elevans/atomic_36/README.md

# atomic_36
My take on a 36 key open source keyboard.
