elevans/atomic_36/case/board_case_with_heated_insert.stl

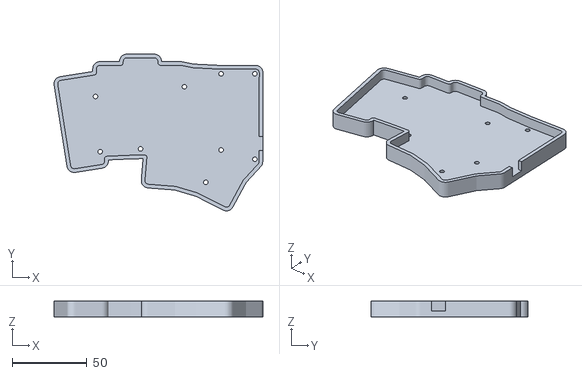
[picture p1: CAD file, 2026-09-09]
case/board_case_with_heated_insert.stl
139.7 x 104.8 x 10.5
