elevans/atomic_36/case/mcu_cover_case.stl

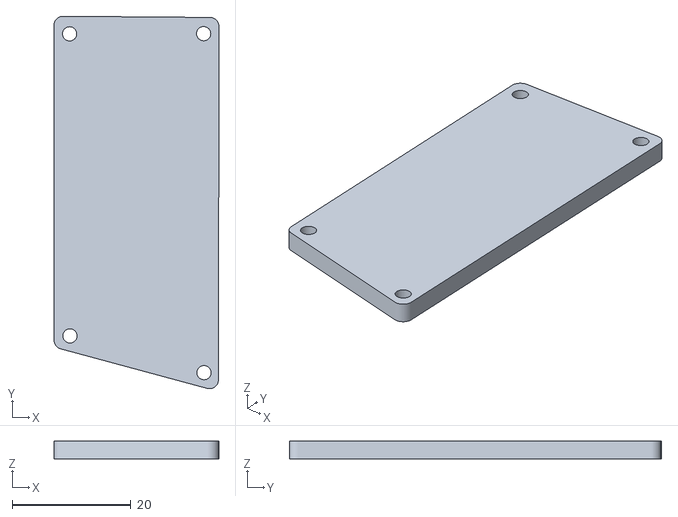
[picture p2: CAD file, 2026-09-05]
case/mcu_cover_case.stl
27.8 x 62.8 x 3.00
