elevans/atomic_36/case/board_case_border_test.stl

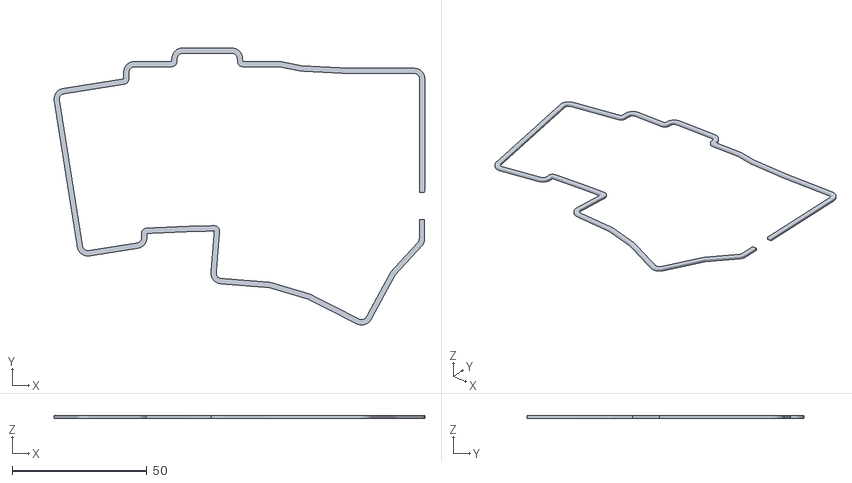
[picture p3: CAD file, 2026-09-05]
case/board_case_border_test.stl
137.9 x 103.0 x 1.00
