elevans/atomic_36/case/switch_plate_case.stl

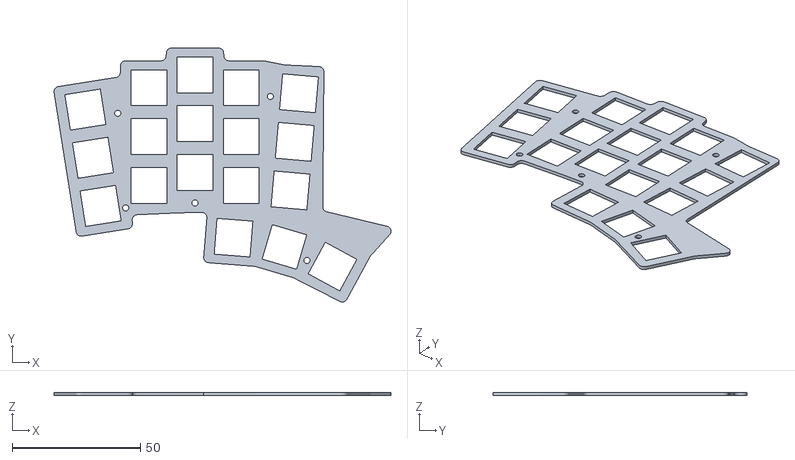
[picture p4: CAD file, 2026-09-05]
case/switch_plate_case.stl
131.3 x 99.0 x 1.20
