elevans/atomic_36/case/board_case.stl

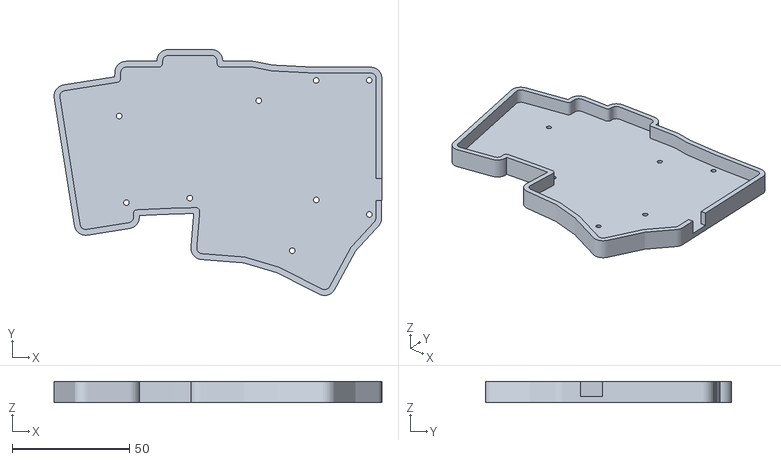
[picture p5: CAD file, 2026-09-05]
case/board_case.stl
139.7 x 104.8 x 9.00
