elevans/atomic_36/pcb/atomic_36.kicad_pcb

## KiCad design pcb/atomic_36.kicad_pcb (2026-08-27)

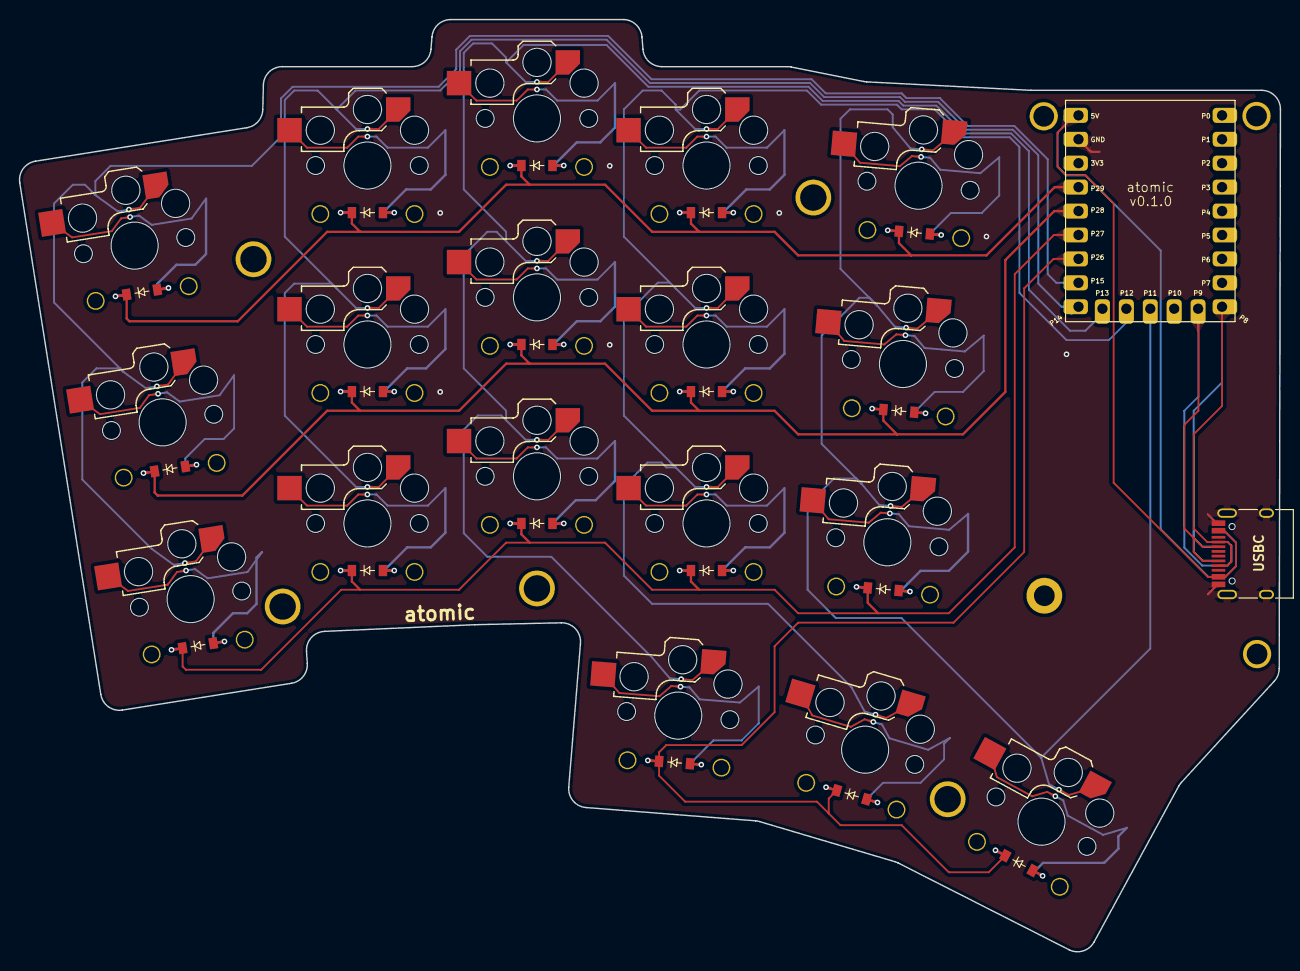
[picture p6: board atomic_36.kicad_pcb from above]

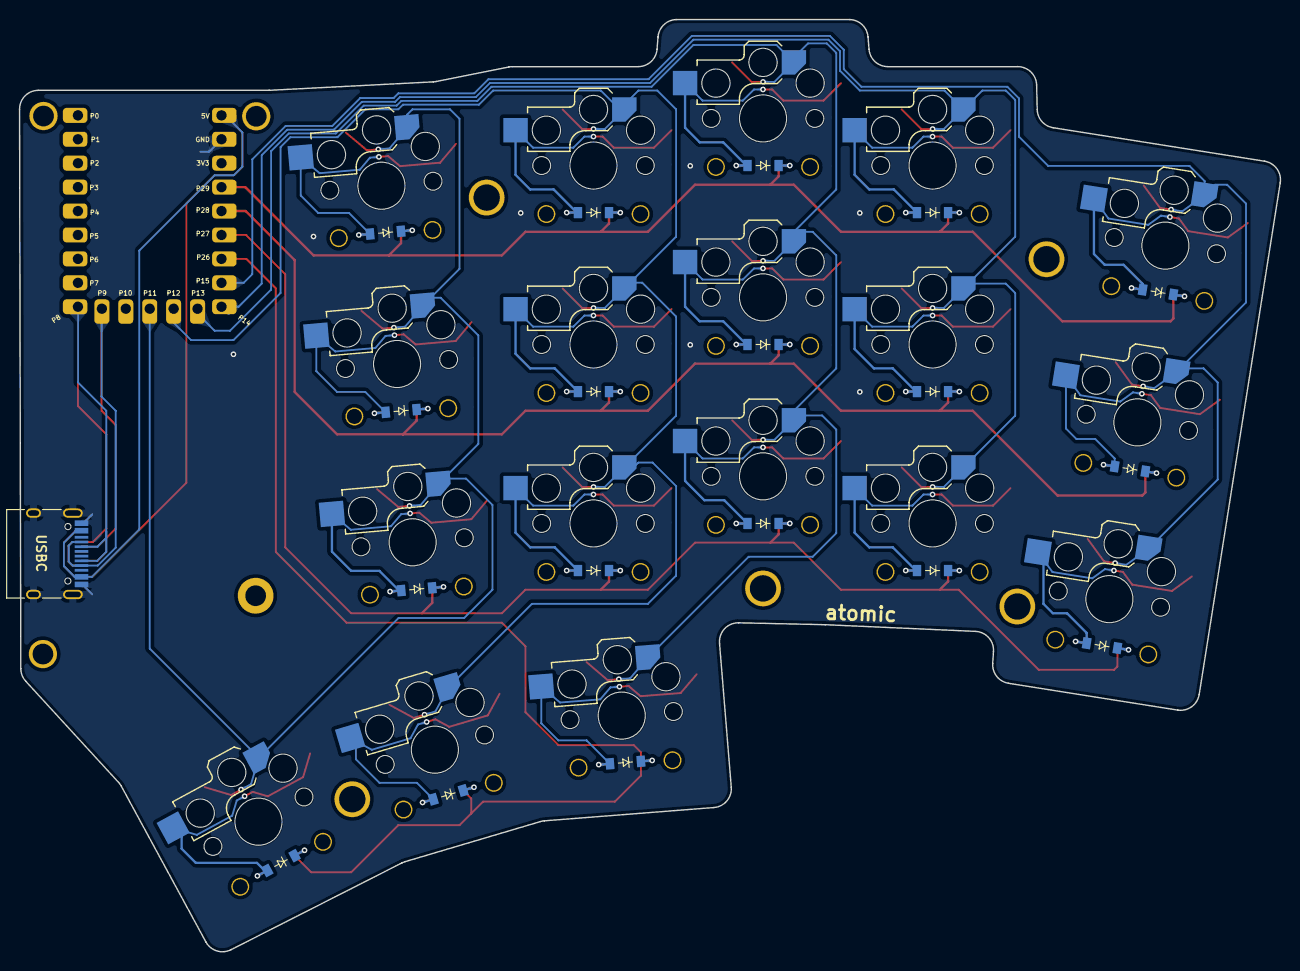
[picture p7: board atomic_36.kicad_pcb from below]

Board: 2 copper layers, 133.9 x 99.0 mm, 47 parts (18 on the bottom side), 31 nets.

Parts:
D1, D2, D3, D4, D5, D6, D7, D8, D9, D10, D11, D12, D13, D14, D15, D16, D17, D18: diode_tht_sod123
H1, H2, H3, H4, H5, H6, H7, H7#2, H9: mounting_hole_plated
J1: USB_C_12P; USB_C_Receptacle_HRO_TYPE-C-31-M-12_Reversible
RP2040Zero1: RP2040-Zero
S1, S2, S3, S4, S5, S6, S7, S8, S9, S10, S11, S12, S13, S14, S15, S16, S17, S18: switch_choc_v1_v2

Connections:
GND: J1.B1, J1.B12, J1.F1, J1.F12, J1.S1, RP2040Zero1.20
GP8: J1.B5, J1.B8, J1.F4, J1.F9, RP2040Zero1.9
GP9: J1.B4, J1.B9, J1.F5, J1.F8, RP2040Zero1.10
GP11: RP2040Zero1.12, S13.1, S14.1, S15.1, S18.1
GP12: RP2040Zero1.13, S10.1, S11.1, S12.1, S17.1
GP13: RP2040Zero1.14, S7.1, S8.1, S9.1, S16.1
GP14: RP2040Zero1.15, S4.1, S5.1, S6.1
GP15: RP2040Zero1.16, S1.1, S2.1, S3.1
GP26: D16.1, D17.1, D18.1, RP2040Zero1.17
GP27: D1.1, D4.1, D7.1, D10.1, D13.1, RP2040Zero1.18
GP28: D2.1, D5.1, D8.1, D11.1, D14.1, RP2040Zero1.22
GP29: D3.1, D6.1, D9.1, D12.1, D15.1, RP2040Zero1.23
P5V: J1.B2, J1.B11, J1.F2, J1.F11, RP2040Zero1.19
index_bottom: D10.2, S10.2
index_home: D11.2, S11.2
index_top: D12.2, S12.2
inner_bottom: D13.2, S13.2
inner_home: D14.2, S14.2
inner_top: D15.2, S15.2
layer_cluster: D17.2, S17.2
middle_bottom: D7.2, S7.2
middle_home: D8.2, S8.2
middle_top: D9.2, S9.2
mod_cluster: D16.2, S16.2
pinky_bottom: D1.2, S1.2
pinky_home: D2.2, S2.2
pinky_top: D3.2, S3.2
ring_bottom: D4.2, S4.2
ring_home: D5.2, S5.2
ring_top: D6.2, S6.2
space_cluster: D18.2, S18.2
