elevans/atomic_36/(commit log)

2026-08-16 Initial commit, add footprints and erogen yml
2026-08-16 Add board outline
2026-08-16 Improve board outline, add combo view
2026-08-16 Refine board outline
2026-08-16 Add switch plate and pcb board
2026-08-16 Fix space thumb cluster pos, clashing
    [atomic_36_config.yaml]
2026-08-17 Fixed rp2040zero footprint, credit chatGPT 5.6
2026-08-17 Add diode and mcu pcb sections
2026-08-17 Add board mirroring, bump to 4.2.1 erogen engine
2026-08-17 Fix x position in outlines
    [atomic_36_config.yaml]
2026-08-17 Remove mirror, we're going reversable
    [atomic_36_config.yaml]
2026-08-17 Add reversable components
    On the left the MCU will face up, on the right
    it will face down!
    [atomic_36_config.yaml]
2026-08-17 Update the usbc 12 pin footprint
    Thanks to GPT for saving me from learning javascript.
2026-08-17 Working 12 pin reversible USBC footrpint for interconnect
2026-08-17 Add USB C interconnect, 12 pin
2026-08-17 Make USB c footprint reversible
    Thanks Gemini, I do not want to learn javascript and
    this just needs to work once more or less.
2026-08-18 Shift usb c link to the edge of the board
2026-08-18 Increase the vertical spacing between keys
    When I printed a test out the keycaps rubbed a bit.
    I'm used to a choc keybaord with MX spacing so more
    space is good.
    [atomic_36_config.yaml]
2026-08-18 Fix board and switch plate shape for thumb cluster
    [atomic_36_config.yaml]
2026-08-18 Create key net for kicad
2026-08-19 Straighten the MCU and adjust the board layout
2026-08-19 Add PCB case mounting holes
2026-08-19 Adjust MCU pos, add component conver holes
2026-08-20 Add case sections WIP
2026-08-20 Minor adjustment to top right PCB
2026-08-20 Fix switch plate right hand side
    [atomic_36_config.yaml]
2026-08-20 Add switch plate mounting holes, update views
2026-08-20 Add mcu cover mounting holes, minor adjustments
2026-08-20 Shift MCU cover right holes
2026-08-20 Shift left MCU cover holes, shift MCU right
2026-08-21 Create switch plate stl, use 13.8 x 13.8 mm cutout
2026-08-21 Add MCU cover, align mounting holes
2026-08-21 Add face down RP2040 zero footprint
2026-08-21 Rename rp2040zero up orientation footprint
2026-08-21 Clean up footprint internal name
2026-08-21 Create filleted MCU cover, align holes
2026-08-21 Extend switch plate towards mcu cover
2026-08-21 Add mcu cover stl
2026-08-21 Add left and right matrix wiring diagram
2026-08-21 Add initial ergogen PCB
    This is not perfect and I will do some custom re-wiring
    [atomic_36.kicad_pcb]
2026-08-21 Begin routing the left side (diodes and switches on back)
    [atomic_36.kicad_pcb]
2026-08-22 Use UART0 GPIO pins for matrix, use UART1 for coms
2026-08-23 Add PCB with MCU up config
    [atomic_36.kicad_pcb]
2026-08-23 Adjust top right side, make flat
    [atomic_36.kicad_pcb]
2026-08-23 Use new PCB export, set track width to 0.3 mm
    [atomic_36.kicad_pcb]
2026-08-23 Add vias to diode pads, make them reversible
2026-08-23 Use plated mounting holes
2026-08-23 Set pad offset to 0.3, prevent mount hole clashing
2026-08-23 Invert column GPIO order
    When routing the board I boxed myself in :(.
    [atomic_36.kicad_pcb]
2026-08-23 Fix col GPIO order...again
    [atomic_36_config.yaml]
2026-08-24 Route the column matrix (back/right)
    [atomic_36.kicad_pcb]
2026-08-24 Complete column (back) routing
    [atomic_36.kicad_pcb]
2026-08-24 Route rows (front)
    [atomic_36.kicad_pcb]
2026-08-24 Route left (central) USB C
    GP8 and GP9 are used as TX and RX. The pins are from
    left to right:
    - GND
    - P5V
    - BLANK
    - GP8 (TX)
    - GP9 (RX)
    - BLANK
    - BLANK
    - GP9 (RX)
    - GP8 (TX)
    - BLANK
    - P5V
    - GND
    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
    [atomic_36.kicad_pcb]
2026-08-24 Route right (peripherial) USB C
    GP8/9 belong to UART1
    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
    [atomic_36.kicad_pcb]
2026-08-24 Fix DRC error, bottom right MCU cover hole issue
    The bottom right MCU plated hole was too close to
    the edge. I used a smaller plated hole (smaller in
    that the plated ring diameter is smaller) from the
    top of the MCU cover. I copied the X / Y positions
    and tripled checked it. This passes DRC and should
    still be in the exact same spot.
    [atomic_36.kicad_pcb]
2026-08-25 Increase mount hole radius size, FDM printing
2026-08-25 Tweak routes, add teardrops
    [atomic_36.kicad_pcb]
2026-08-25 Increase PCB matrix mounting hole size to 2.8 mm
    [atomic_36.kicad_pcb]
2026-08-25 Add ground plane and silkscreen labels
    [atomic_36.kicad_pcb]
2026-08-26 Add final tweaks to PCB before ordering
    [atomic_36.kicad_pcb]
2026-08-27 Add base plate w/ holes
2026-08-27 Add bottom case stl, with mounting holes
2026-08-27 Make space for MCU standoffs
2026-08-27 Increase key hole size for FDM printing (20 %)
2026-08-27 Set gerber job to no
    [atomic_36.kicad_pcb]
2026-08-28 Add board matrix and keyboard layout (base)
2026-08-29 Add USBC cutout to the case border
2026-08-29 Add USBC support to the case border
2026-08-30 Increase case border to 2.5 mm
2026-08-31 Add PCB clearance and tighten up the USBC port hole
    [atomic_36_config.yaml]
2026-09-05 Add clearance for the PCB
    I actually have the PCBs now and it fits great!
    [atomic_36_config.yaml]
2026-09-05 Add case STLs
    [board_case.stl, board_case_border_test.stl, mcu_cover_case.stl, switch_plate_case.stl]
2026-09-09 Add heated insert case variant
    [board_case_with_heated_insert.stl]
